rh960/Sensor_Driven_Digital_Twin_For_Collison_Prevention_in_Autonomous_Systems/Phase1 Carla Project Python Scripts/Phase1_README.md

# Phase 1 — CARLA Simulation Baseline

This phase establishes the simulation foundation for the project using the CARLA autonomous driving simulator. It implements YOLOv8n object detection, LiDAR and radar sensor fusion, TTC-based emergency braking logic, and tests across adverse weather conditions in Town04.

---

## Folder Structure

```
Phase1 Carla Project Python Scripts/
├── Initial_Tests_Scripts/              # Early development and live visualisation scripts
│   ├── carla_live_viewer.py            # Basic CARLA world viewer
│   ├── dt_phase1_car_front.py          # Single-obstacle Digital Twin script
│   ├── dt_phase1_car_front_multi_obs_.py  # Multi-obstacle version
│   ├── dt_phase1_car_front_rain.py     # Adverse weather (rain) variant
│   ├── frames_to_video.py              # Frame sequence to MP4 conversion
│   ├── Live_Visualisation.py           # Real-time sensor visualisation (v1)
│   ├── Live_Visualisation2.py          # Visualisation iteration 2
│   ├── Live_Visualisation3.py          # Visualisation iteration 3
│   ├── Live_Visualisation_with_YOLO.py       # YOLOv8 integrated visualisation
│   ├── Live_Visualisation_with_YOLO_lane.py  # YOLOv8 + lane detection variant
│   ├── record_carla_video.py           # CARLA recording utility
│   ├── Sample test carla.py            # Basic connection test
│   ├── sensor_comparison.png           # Sensor performance comparison chart
│   └── yolo_performance.png            # YOLOv8 performance chart
│
├── Python Obstacle Scripts and results/   # Final obstacle avoidance scripts + output data
│   ├── dt_phase1_car_front.py
│   ├── dt_phase1_car_front_multi_obs_.py
│   ├── dt_phase1_car_front_rain.py
│   ├── Dark extreme rain.mp4
│   ├── Extreme Rain Headlights on.mp4
│   └── Multi Object Avoidance.mp4
│
├── Output_Videos/                      # All recorded simulation runs
│   ├── output1.mp4 – output4.mp4       # Progressive development runs
│   ├── Dark extreme rain.mp4
│   ├── Extreme Rain Headlights on.mp4
│   ├── Multi Object Avoidance.mp4
│   ├── radar_data.csv                  # Logged radar sensor data
│   ├── sensor_analysis.csv             # Post-run sensor performance analysis
│   ├── sensor_fusion.csv               # Fusion output log
│   ├── vehicle_state.csv               # Vehicle state log over time
│   ├── yolo_analysis.csv               # YOLOv8 detection log
│   ├── yolo_performance.csv            # YOLOv8 frame-by-frame metrics
│   ├── comprehensive_analysis.png      # Summary performance chart
│   └── yolo_performance.png
│
└── Visualisation Scripts/              # Standalone visualisation tools
    ├── Live_Visualisation.py
    ├── Live_Visualisation2.py
    ├── Live_Visualisation3.py
    ├── Live_Visualisation_with_YOLO.py
    └── Live_Visualisation_with_YOLO_lane.py
```

---

## Setup and Requirements

### Prerequisites

- Python 3.8 or later
- CARLA simulator 0.9.13 or later ([carla.org](https://carla.org/))
- CARLA Python API (included with the CARLA installation)

### Python Dependencies

```bash
pip install numpy opencv-python matplotlib ultralytics pygame
```

For YOLOv8 specifically:

```bash
pip install ultralytics
```

### Running CARLA

Start the CARLA server before running any script:

```bash
# Windows
CarlaUE4.exe

# Linux
./CarlaUE4.sh
```

CARLA runs on `localhost:2000` by default. All scripts connect to this address.

---

## Running the Scripts

### Basic single-obstacle test

```bash
python "Initial_Tests_Scripts/dt_phase1_car_front.py"
```

### Multi-obstacle avoidance

```bash
python "Initial_Tests_Scripts/dt_phase1_car_front_multi_obs_.py"
```

### Adverse weather (rain scenario)

```bash
python "Initial_Tests_Scripts/dt_phase1_car_front_rain.py"
```

### Live visualisation with YOLOv8

```bash
python "Initial_Tests_Scripts/Live_Visualisation_with_YOLO.py"
```

### Convert recorded frames to video

```bash
python "Initial_Tests_Scripts/frames_to_video.py"
```

---

## What the Simulation Tests

- **Town04** map (CARLA's highway/suburban environment)
- Single and multiple static/dynamic obstacle scenarios
- Adverse weather: heavy rain, reduced visibility, headlights-on conditions
- YOLOv8n detection performance under normal and degraded visual conditions
- TTC-based emergency braking trigger thresholds
- LiDAR and radar sensor fusion producing a combined collision risk verdict

---

## Output Data

All videos and CSV logs are generated by running the scripts against a live CARLA instance — they are not included in the repository. Running any of the obstacle scripts will produce MP4 output files and the following CSV logs in the working directory:

| File | Contents |
|---|---|
| `sensor_fusion.csv` | Frame-by-frame fusion verdict (SAFE / CAUTION / IMMINENT) |
| `radar_data.csv` | Raw radar range and velocity readings |
| `vehicle_state.csv` | Speed, position, and braking state per frame |
| `yolo_performance.csv` | Detection confidence and class per frame |
| `comprehensive_analysis.png` | Summary chart across all sensor metrics |
