rh960/Sensor_Driven_Digital_Twin_For_Collison_Prevention_in_Autonomous_Systems/Phase2 Hardware Python Scripts/initial_Test_Debug_Scripts/Untitled-1.md

wget https://download.nomachine.com/download/8.11/Linux/nomachine_8.11.3_1_arm64.deb

sudo dpkg -i nomachine_8.11.3_1_arm64.deb

sudo /etc/NX/nxserver --status
