rh960/Sensor_Driven_Digital_Twin_For_Collison_Prevention_in_Autonomous_Systems/Phase2 Hardware Python Scripts/Hardware Tests/avoidance_log_20260401_174341.csv

timestamp | fusion_level | lidar_fl_m | lidar_fc_m | lidar_fr_m | radar_range_m | radar_velocity_mps | radar_ttc_s | camera_class | camera_dist_level | motor_state | retry_count | action_taken
2026-04-01 17:45:52.224 | IMMINENT | 0.39 | 2.34 | 2.28 | none | none | none | none | none | NORMAL | 0 | driving_forward
2026-04-01 17:45:52.300 | IMMINENT | 0.37 | 2.34 | 2.26 | none | none | none | none | none | NORMAL | 0 | driving_forward
2026-04-01 17:45:52.357 | IMMINENT | 0.36 | 2.34 | 2.26 | none | none | none | none | none | NORMAL | 0 | driving_forward
2026-04-01 17:45:52.414 | IMMINENT | 0.34 | 0.36 | 2.26 | none | none | none | none | none | NORMAL | 0 | driving_forward
2026-04-01 17:45:52.481 | IMMINENT | 0.34 | 0.36 | 2.26 | none | none | none | none | none | NORMAL | 0 | driving_forward
2026-04-01 17:45:52.542 | IMMINENT | 0.29 | 0.3 | 2.26 | none | none | none | none | none | NORMAL | 0 | driving_forward
2026-04-01 17:45:52.606 | IMMINENT | 0.24 | 0.24 | 2.45 | none | none | none | none | none | NORMAL | 0 | driving_forward
2026-04-01 17:45:52.670 | IMMINENT | 0.24 | 0.24 | 2.45 | none | none | none | none | none | NORMAL | 0 | driving_forward
2026-04-01 17:45:52.734 | IMMINENT | 0.21 | 0.22 | 2.27 | none | none | none | none | none | NORMAL | 0 | driving_forward
2026-04-01 17:45:52.798 | IMMINENT | 0.21 | 0.22 | 2.27 | none | none | none | none | none | NORMAL | 0 | driving_forward
2026-04-01 17:45:52.862 | IMMINENT | 0.21 | 0.22 | 2.27 | none | none | none | none | none | NORMAL | 0 | driving_forward
2026-04-01 17:45:52.927 | IMMINENT | 0.21 | 0.22 | 2.26 | none | none | none | none | none | NORMAL | 0 | driving_forward
2026-04-01 17:45:52.990 | IMMINENT | 0.21 | 0.22 | 2.26 | none | none | none | none | none | NORMAL | 0 | driving_forward
2026-04-01 17:45:53.060 | IMMINENT | 0.22 | 0.23 | 2.26 | none | none | none | none | none | NORMAL | 0 | driving_forward
2026-04-01 17:45:53.118 | IMMINENT | 0.22 | 0.23 | 2.26 | none | none | none | none | none | NORMAL | 0 | driving_forward
2026-04-01 17:45:53.183 | IMMINENT | 0.22 | 0.23 | 2.26 | none | none | none | none | none | NORMAL | 0 | driving_forward
2026-04-01 17:45:53.248 | IMMINENT | 0.2 | 0.23 | 2.26 | none | none | none | none | none | NORMAL | 0 | driving_forward
2026-04-01 17:45:53.312 | IMMINENT | 0.2 | 0.23 | 2.26 | none | none | none | none | none | NORMAL | 0 | driving_forward
2026-04-01 17:45:53.375 | IMMINENT | 0.2 | 0.23 | 2.26 | none | none | none | none | none | NORMAL | 0 | driving_forward
2026-04-01 17:45:53.439 | IMMINENT | 0.2 | 0.23 | 2.26 | none | none | none | none | none | NORMAL | 0 | driving_forward
2026-04-01 17:45:53.502 | IMMINENT | 0.2 | 0.23 | 2.26 | none | none | none | none | none | NORMAL | 0 | driving_forward
2026-04-01 17:45:53.566 | IMMINENT | 0.22 | 0.23 | 2.26 | none | none | none | none | none | NORMAL | 0 | driving_forward
2026-04-01 17:45:53.630 | IMMINENT | 0.3 | 2.25 | 2.26 | none | none | none | none | none | NORMAL | 0 | driving_forward
2026-04-01 17:45:53.695 | IMMINENT | 0.3 | 2.25 | 2.26 | none | none | none | none | none | NORMAL | 0 | driving_forward
2026-04-01 17:45:53.759 | SAFE | 2.25 | 2.25 | 2.26 | none | none | none | none | none | NORMAL | 0 | driving_forward
2026-04-01 17:45:55.934 | IMMINENT | 2.25 | 2.27 | 0.38 | none | none | none | none | none | NORMAL | 0 | driving_forward
2026-04-01 17:45:56.000 | IMMINENT | 2.26 | 2.27 | 0.38 | none | none | none | none | none | NORMAL | 0 | driving_forward
2026-04-01 17:45:56.063 | IMMINENT | 2.26 | 2.27 | 0.38 | none | none | none | none | none | NORMAL | 0 | driving_forward
2026-04-01 17:45:56.126 | IMMINENT | 2.26 | 2.27 | 0.38 | none | none | none | none | none | NORMAL | 0 | driving_forward
2026-04-01 17:45:56.191 | IMMINENT | 2.26 | 2.25 | 0.38 | none | none | none | none | none | NORMAL | 0 | driving_forward
2026-04-01 17:45:56.254 | SAFE | 2.26 | 2.25 | 2.26 | none | none | none | none | none | NORMAL | 0 | driving_forward
2026-04-01 17:45:56.382 | IMMINENT | 2.26 | 2.25 | 2.26 | none | none | none | person | IMMINENT | NORMAL | 0 | driving_forward
2026-04-01 17:45:56.448 | IMMINENT | 2.26 | 2.25 | 2.26 | none | none | none | person | IMMINENT | NORMAL | 0 | driving_forward
2026-04-01 17:45:56.511 | SAFE | 2.26 | 2.27 | 2.26 | none | none | none | none | none | NORMAL | 0 | driving_forward
2026-04-01 17:45:57.022 | IMMINENT | 2.27 | 2.27 | 0.32 | none | none | none | none | none | NORMAL | 0 | driving_forward
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
2026-04-01 17:46:02.478 | SAFE | 2.26 | 2.25 | 2.26 | none | none | none | none | none | REVERSING | 0 | reversing_straight
2026-04-01 17:46:02.990 | IMMINENT | 2.26 | 2.27 | 0.33 | none | none | none | none | none | REVERSING | 0 | reversing_straight
2026-04-01 17:46:03.075 | IMMINENT | 2.26 | 2.27 | 0.33 | none | none | none | none | none | REVERSING | 0 | reversing_straight
2026-04-01 17:46:03.136 | IMMINENT | 2.26 | 2.27 | 0.33 | none | none | none | none | none | REVERSING | 0 | reversing_straight
2026-04-01 17:46:03.195 | IMMINENT | 2.26 | 2.27 | 0.33 | none | none | none | none | none | REVERSING | 0 | reversing_straight
2026-04-01 17:46:03.260 | IMMINENT | 2.27 | 2.27 | 0.32 | none | none | none | none | none | REVERSING | 0 | reversing_straight
2026-04-01 17:46:03.317 | IMMINENT | 2.27 | 2.27 | 0.32 | none | none | none | none | none | REVERSING | 0 | reversing_straight
2026-04-01 17:46:03.377 | IMMINENT | 2.26 | 2.27 | 0.32 | none | none | none | none | none | REVERSING | 0 | reversing_straight
2026-04-01 17:46:03.438 | IMMINENT | 2.26 | 2.27 | 0.32 | none | none | none | none | none | REVERSING | 0 | reversing_straight
2026-04-01 17:46:03.502 | IMMINENT | 2.26 | 2.27 | 0.32 | none | none | none | none | none | REVERSING | 0 | reversing_straight
2026-04-01 17:46:03.567 | SAFE | 2.26 | 2.27 | 2.25 | none | none | none | none | none | REVERSING | 0 | reversing_straight
2026-04-01 17:46:04.462 | SAFE | 2.26 | 2.27 | 2.26 | none | none | none | none | none | TURNING | 0 | turning_escape
2026-04-01 17:46:04.528 | SAFE | 2.26 | 2.27 | 2.26 | none | none | none | none | none | ESCAPING | 0 | forward_on_new_heading
2026-04-01 17:46:05.550 | SAFE | 2.27 | 2.27 | 2.26 | none | none | none | none | none | NORMAL | 0 | driving_forward
2026-04-01 17:46:10.351 | IMMINENT | 2.26 | 2.27 | 0.31 | none | none | none | none | none | NORMAL | 0 | driving_forward
2026-04-01 17:46:10.424 | IMMINENT | 2.26 | 2.25 | 0.29 | none | none | none | none | none | NORMAL | 0 | driving_forward
2026-04-01 17:46:10.486 | IMMINENT | 2.26 | 2.25 | 0.29 | none | none | none | none | none | NORMAL | 0 | driving_forward
2026-04-01 17:46:10.550 | IMMINENT | 2.26 | 2.25 | 0.29 | none | none | none | none | none | NORMAL | 0 | driving_forward
2026-04-01 17:46:10.613 | IMMINENT | 2.26 | 2.25 | 0.29 | none | none | none | none | none | NORMAL | 0 | driving_forward
2026-04-01 17:46:10.681 | IMMINENT | 2.26 | 2.25 | 0.29 | none | none | none | none | none | NORMAL | 0 | driving_forward
2026-04-01 17:46:10.740 | IMMINENT | 2.26 | 2.27 | 0.29 | none | none | none | none | none | NORMAL | 0 | driving_forward
2026-04-01 17:46:10.798 | IMMINENT | 2.26 | 2.27 | 0.29 | none | none | none | umbrella | IMMINENT | NORMAL | 0 | driving_forward
2026-04-01 17:46:10.865 | IMMINENT | 2.26 | 2.27 | 0.29 | none | none | none | umbrella | IMMINENT | NORMAL | 0 | driving_forward
2026-04-01 17:46:10.927 | IMMINENT | 2.26 | 2.27 | 0.31 | none | none | none | none | none | NORMAL | 0 | driving_forward
2026-04-01 17:46:10.990 | IMMINENT | 2.26 | 2.27 | 0.31 | none | none | none | none | none | NORMAL | 0 | driving_forward
2026-04-01 17:46:11.056 | IMMINENT | 2.27 | 2.27 | 0.33 | none | none | none | none | none | NORMAL | 0 | driving_forward
2026-04-01 17:46:11.118 | IMMINENT | 2.27 | 2.27 | 0.33 | none | none | none | none | none | NORMAL | 0 | driving_forward
2026-04-01 17:46:11.183 | IMMINENT | 2.27 | 2.27 | 0.34 | none | none | none | none | none | NORMAL | 0 | driving_forward
2026-04-01 17:46:11.246 | IMMINENT | 2.26 | 2.27 | 0.35 | none | none | none | none | none | NORMAL | 0 | driving_forward
2026-04-01 17:46:11.310 | IMMINENT | 2.26 | 2.27 | 0.35 | none | none | none | umbrella | IMMINENT | NORMAL | 0 | driving_forward
2026-04-01 17:46:11.374 | IMMINENT | 2.26 | 2.27 | 0.37 | none | none | none | umbrella | IMMINENT | NORMAL | 0 | driving_forward
2026-04-01 17:46:11.438 | IMMINENT | 2.26 | 2.27 | 0.4 | none | none | none | umbrella | IMMINENT | NORMAL | 0 | driving_forward
2026-04-01 17:46:11.506 | IMMINENT | 2.26 | 2.27 | 0.4 | none | none | none | umbrella | IMMINENT | NORMAL | 0 | driving_forward
2026-04-01 17:46:11.566 | IMMINENT | 2.26 | 2.27 | 2.26 | none | none | none | umbrella | IMMINENT | NORMAL | 0 | driving_forward
2026-04-01 17:46:11.631 | IMMINENT | 2.26 | 2.27 | 2.26 | none | none | none | umbrella | IMMINENT | NORMAL | 0 | driving_forward
2026-04-01 17:46:11.694 | IMMINENT | 2.26 | 2.27 | 2.26 | none | none | none | umbrella | IMMINENT | NORMAL | 0 | driving_forward
2026-04-01 17:46:11.758 | IMMINENT | 2.26 | 2.27 | 2.26 | none | none | none | umbrella | IMMINENT | NORMAL | 0 | driving_forward
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
2026-04-01 17:47:24.174 | IMMINENT | 0.99 | 0.2 | 1.89 | none | none | none | none | none | NORMAL | 0 | driving_forward
2026-04-01 17:47:24.239 | IMMINENT | 0.99 | 0.2 | 1.89 | none | none | none | none | none | NORMAL | 0 | driving_forward
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
