rh960/Sensor_Driven_Digital_Twin_For_Collison_Prevention_in_Autonomous_Systems/Phase1 Carla Project Python Scripts/Yolo_Comparison1/yolo_results_20260403_122553/yolo26/lidar_data.csv

timestamp | frame | min_distance_m | lateral_offset_m | point_count
101691.55257141031 | 2598879 | 4.331724166870117 | -0.6164453029632568 | 1435
101691.6525714118 | 2598881 | 4.331739902496338 | 0.3090234398841858 | 1509
101691.70257141255 | 2598882 | 4.332093238830566 | -0.30906248092651367 | 1396
101691.7525714133 | 2598883 | 4.332760334014893 | 1.514062523841858 | 1505
101691.80257141404 | 2598884 | 4.333622455596924 | -1.9398436546325684 | 1415
101691.85257141478 | 2598885 | 4.334146499633789 | 1.940039038658142 | 1475
101691.90257141553 | 2598886 | 4.334775447845459 | -1.9403125047683716 | 1473
101691.95257141627 | 2598887 | 4.335229873657227 | 1.9405077695846558 | 1425
101692.00257141702 | 2598888 | 4.3357014656066895 | -1.9407421350479126 | 1444
101692.05257141776 | 2598889 | 4.336033344268799 | 1.9409373998641968 | 1470
101692.10257141851 | 2598890 | 4.336329936981201 | -1.941015601158142 | 1460
101692.15257141925 | 2598891 | 4.336577415466309 | 1.8014843463897705 | 1494
101692.20257142 | 2598892 | 4.336958408355713 | -1.2218358516693115 | 1425
101692.25257142074 | 2598893 | 4.336892604827881 | 1.801601529121399 | 1487
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
