rh960/Sensor_Driven_Digital_Twin_For_Collison_Prevention_in_Autonomous_Systems/Phase1 Carla Project Python Scripts/Yolo_Comparison1/yolo_results_20260403_122553/yolo26/sensor_fusion.csv

time_s | true_dist_m | radar_dist_m | lidar_dist_m | fused_dist_m | relative_vel_mps | ttc_s | safety_level
0.0017199516296386719 | 73.68693082817028 | 999.0 | 999.0 | 999.0 | 0.0 | 999.0 | SAFE
0.01301431655883789 | 73.68693082817028 | 15.206235885620117 | 999.0 | 999.0 | 4105.431640625 | 999.0 | SAFE
0.15003156661987305 | 73.6869156792851 | 15.206235885620117 | 4.331724166870117 | 999.0 | 4105.431640625 | 999.0 | SAFE
0.18524765968322754 | 73.68517355779194 | 11.668526649475098 | 4.331739902496338 | 999.0 | 0.00591819201331858 | 999.0 | SAFE
0.23920965194702148 | 73.67991689918318 | 12.780374526977539 | 4.332093238830566 | 999.0 | 0.16241900746100543 | 999.0 | SAFE
0.2973659038543701 | 73.66834318017568 | 11.966495513916016 | 4.332760334014893 | 999.0 | 0.2660323249055016 | 999.0 | SAFE
0.3494729995727539 | 73.65224314094053 | 12.725211143493652 | 4.333622455596924 | 999.0 | 0.37963000914690476 | 999.0 | SAFE
0.4046909809112549 | 73.62899296813441 | 13.091492652893066 | 4.334146499633789 | 999.0 | 0.49198075344591596 | 999.0 | SAFE
0.474651575088501 | 73.59905770121028 | 12.765198707580566 | 4.334775447845459 | 999.0 | 0.6352763755141565 | 999.0 | SAFE
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
