rh960/Sensor_Driven_Digital_Twin_For_Collison_Prevention_in_Autonomous_Systems/Phase1 Carla Project Python Scripts/Yolo_Comparison1/yolo_results_20260403_122553/yolo26/vehicle_state.csv

time_s | ego_speed_mps | ego_x | ego_y | ego_yaw | throttle | brake | steer | action | decision_reason
0.0017199516296386719 | 0.0 | 225.72586059570312 | -364.1121826171875 | -0.2099609524011612 | 0.5 | 0.0 | -0.0027096783742308617 | DRIVING | Path clear
0.01301431655883789 | 0.0025508618503261044 | 225.72586059570312 | -364.1121826171875 | -0.2099609524011612 | 0.5 | 0.0 | -0.0027184931095689535 | DRIVING | Path clear
0.15003156661987305 | 0.00032199342473715356 | 225.7258758544922 | -364.1121826171875 | -0.2099609524011612 | 0.5 | 0.0 | -0.0027093649841845036 | DRIVING | Path clear
0.18524765968322754 | 0.00591819201331858 | 225.72763061523438 | -364.1121826171875 | -0.2100525051355362 | 0.5 | 0.0 | -0.0027123061008751392 | DRIVING | Path clear
0.23920965194702148 | 0.16241900746100543 | 225.73292541503906 | -364.1121826171875 | -0.2085265964269638 | 0.5 | 0.0 | -0.002773751737549901 | DRIVING | Path clear
0.2973659038543701 | 0.2660323249055016 | 225.7445831298828 | -364.1121826171875 | -0.211639404296875 | 0.5 | 0.0 | -0.002695750677958131 | DRIVING | Path clear
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
