rh960/Sensor_Driven_Digital_Twin_For_Collison_Prevention_in_Autonomous_Systems/Phase1 Carla Project Python Scripts/Yolo_Comparison1/yolo_results_20260403_122553/yolo26/yolo_performance.csv

frame | inference_time_ms | num_detections | detected_classes
0 | 76.75480842590332 | 0
1 | 21.747589111328125 | 0
2 | 21.813631057739258 | 0
3 | 21.38662338256836 | 0
4 | 21.120786666870117 | 0
5 | 21.066665649414062 | 0
6 | 21.165132522583008 | 0
7 | 22.11284637451172 | 0
8 | 21.420001983642578 | 0
9 | 21.08025550842285 | 0
10 | 21.094083786010742 | 0
11 | 21.253585815429688 | 0
12 | 21.46434783935547 | 0
13 | 21.113872528076172 | 0
14 | 21.430253982543945 | 0
15 | 21.465539932250977 | 0
16 | 21.676301956176758 | 0
17 | 21.625757217407227 | 0
18 | 22.06254005432129 | 0
19 | 21.54231071472168 | 0
20 | 21.38829231262207 | 0
21 | 21.193981170654297 | 0
22 | 21.273374557495117 | 0
23 | 21.425485610961914 | 0
24 | 20.9658145904541 | 0
25 | 21.702051162719727 | 0
26 | 21.116256713867188 | 0
27 | 22.75538444519043 | 0
28 | 21.357297897338867 | 0
29 | 20.97606658935547 | 0
30 | 20.96700668334961 | 0
31 | 20.678997039794922 | 0
32 | 20.679712295532227 | 0
33 | 21.24953269958496 | 0
34 | 20.908594131469727 | 0
35 | 21.024703979492188 | 0
36 | 20.91050148010254 | 0
37 | 21.341800689697266 | 0
38 | 20.74742317199707 | 0
39 | 21.00062370300293 | 0
40 | 20.75362205505371 | 0
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
