rh960/Sensor_Driven_Digital_Twin_For_Collison_Prevention_in_Autonomous_Systems/Phase1 Carla Project Python Scripts/Initial_Tests_Scripts/yolo_performance.png

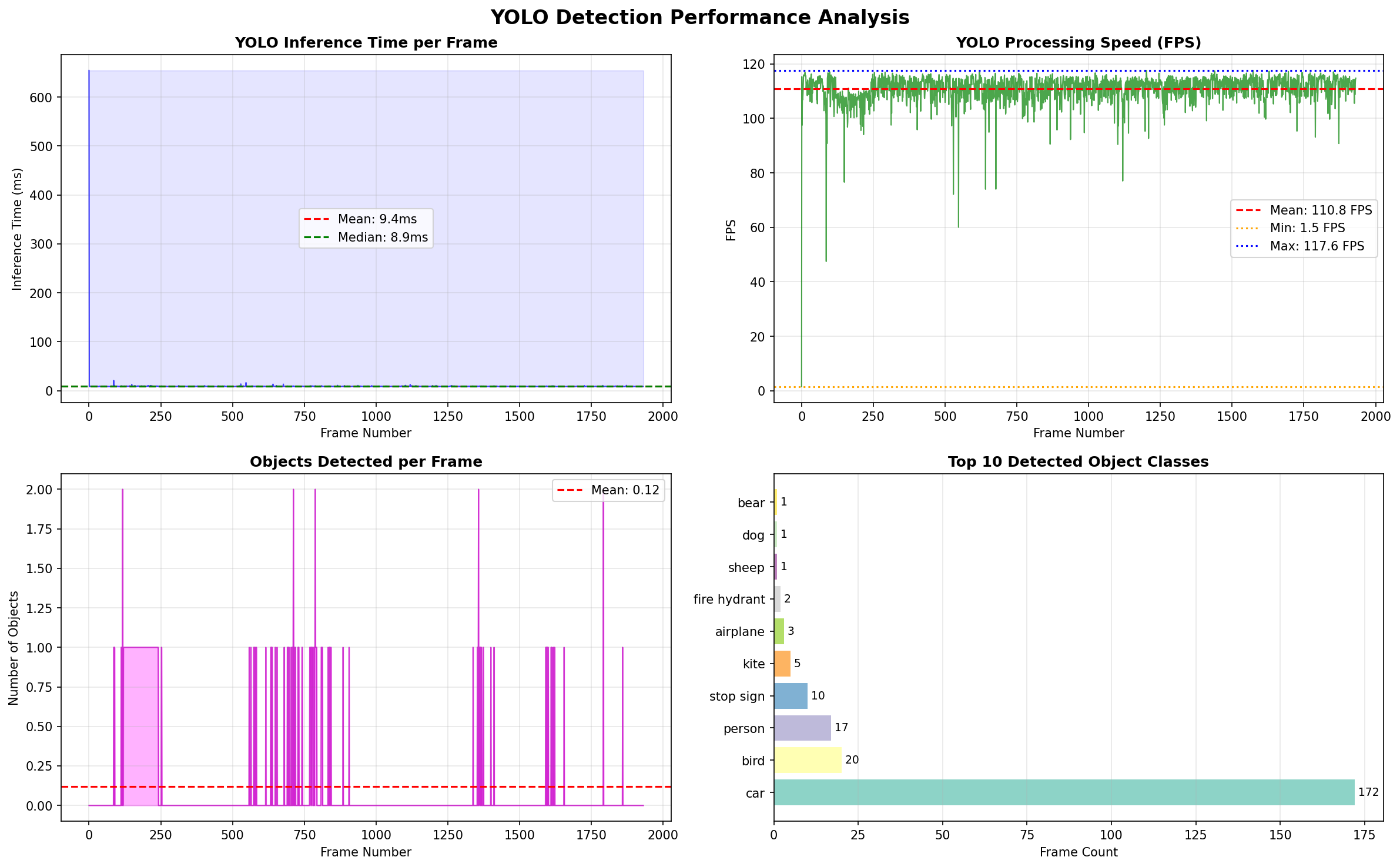
Phase1 Carla Project Python Scripts/Initial_Tests_Scripts/yolo_performance.png
