rh960/Sensor_Driven_Digital_Twin_For_Collison_Prevention_in_Autonomous_Systems/Phase1 Carla Project Python Scripts/Yolo_Comparison1/yolo_results_20260403_122553/yolo_comparison_fps_box.png

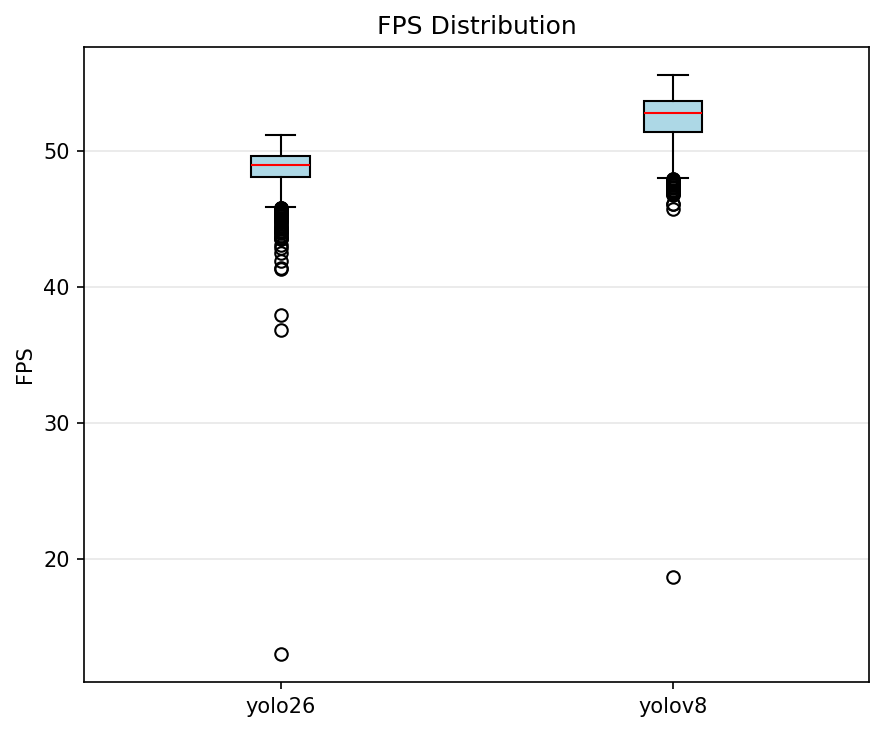
Phase1 Carla Project Python Scripts/Yolo_Comparison1/yolo_results_20260403_122553/yolo_comparison_fps_box.png
