rh960/Sensor_Driven_Digital_Twin_For_Collison_Prevention_in_Autonomous_Systems/Phase1 Carla Project Python Scripts/Yolo_Comparison2/yolo_results_20260403_122553/yolo_comparison_inftime_series.png

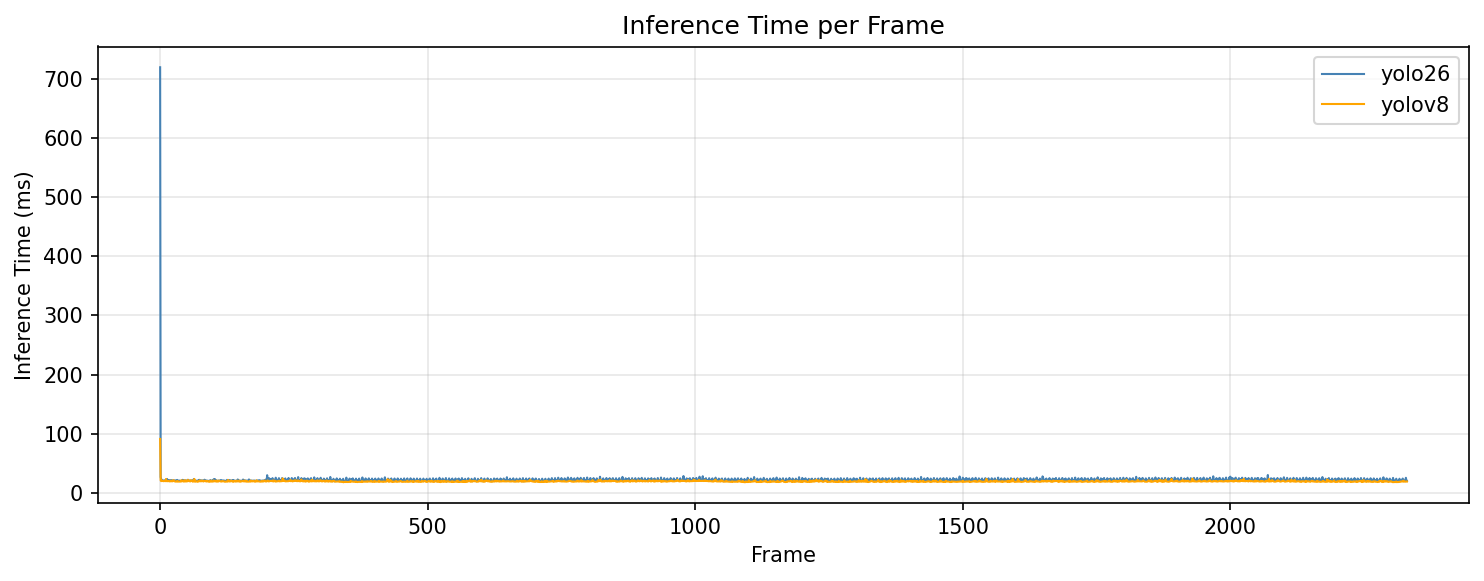
Phase1 Carla Project Python Scripts/Yolo_Comparison2/yolo_results_20260403_122553/yolo_comparison_inftime_series.png
