rh960/Sensor_Driven_Digital_Twin_For_Collison_Prevention_in_Autonomous_Systems/Phase2 Hardware Python Scripts/initial_Test_Debug_Scripts/run_example_range_doppler.py

import multiprocessing
import time
import subprocess


def run_script1():
    # Start the first Python script
    subprocess.run(["python", "visualization_range_doppler.py"])


def run_script2():
    # Start the second Python script
    subprocess.run(["python", "udp_streaming_range_doppler.py"])


if __name__ == "__main__":
    # Create a process for the first script
    process1 = multiprocessing.Process(target=run_script1)
    # Start the first process
    process1.start()

    # Wait for 20 seconds before starting the second script
    time.sleep(20)

    # Create a process for the second script
    process2 = multiprocessing.Process(target=run_script2)
    # Start the second process
    process2.start()

    # Wait for both processes to complete
    process1.join()
    process2.join()
