rh960/Sensor_Driven_Digital_Twin_For_Collison_Prevention_in_Autonomous_Systems/Phase2 Hardware Python Scripts/initial_Test_Debug_Scripts/camera_test.py

# Test with GStreamer pipeline
python3 -c "
import cv2
cap = cv2.VideoCapture('nvarguscamerasrc ! video/x-raw(memory:NVMM), width=1280, height=720, framerate=30/1 ! nvvidconv ! video/x-raw, format=BGRx ! videoconvert ! video/x-raw, format=BGR ! appsink', cv2.CAP_GSTREAMER)
print('Camera opened:', cap.isOpened())
ret, frame = cap.read()
print('Frame captured:', ret)
if ret:
    print('Resolution:', frame.shape)
cap.release()
"
