rh960/Sensor_Driven_Digital_Twin_For_Collison_Prevention_in_Autonomous_Systems/(commit log)

2026-03-25 Motor controller serial GPIO + WiFi UDP, Arduino dual control
2026-03-25 Changes in motorcontroller logic
2026-03-26 Changes jetson gui file and new data logging file
2026-03-30 Changes in motor controller
2026-04-01 Changes to data logger motor controller and jetson file
2026-04-02 Changes in MotorController and jetson Fusion file
    [avoidance_log_20260401_174341.csv, avoidance_log_20260401_181711.csv]
2026-04-04 New Yolo Comparison scripts added comparing YOLOv8n to YOLOv5n
    [lidar_data.csv, radar_data.csv, sensor_fusion.csv, vehicle_state.csv, yolo_performance.csv, yolo_summary.csv]
